marcin-chwedczuk/arducam/kicad/arducam/plot/arducam.pdf

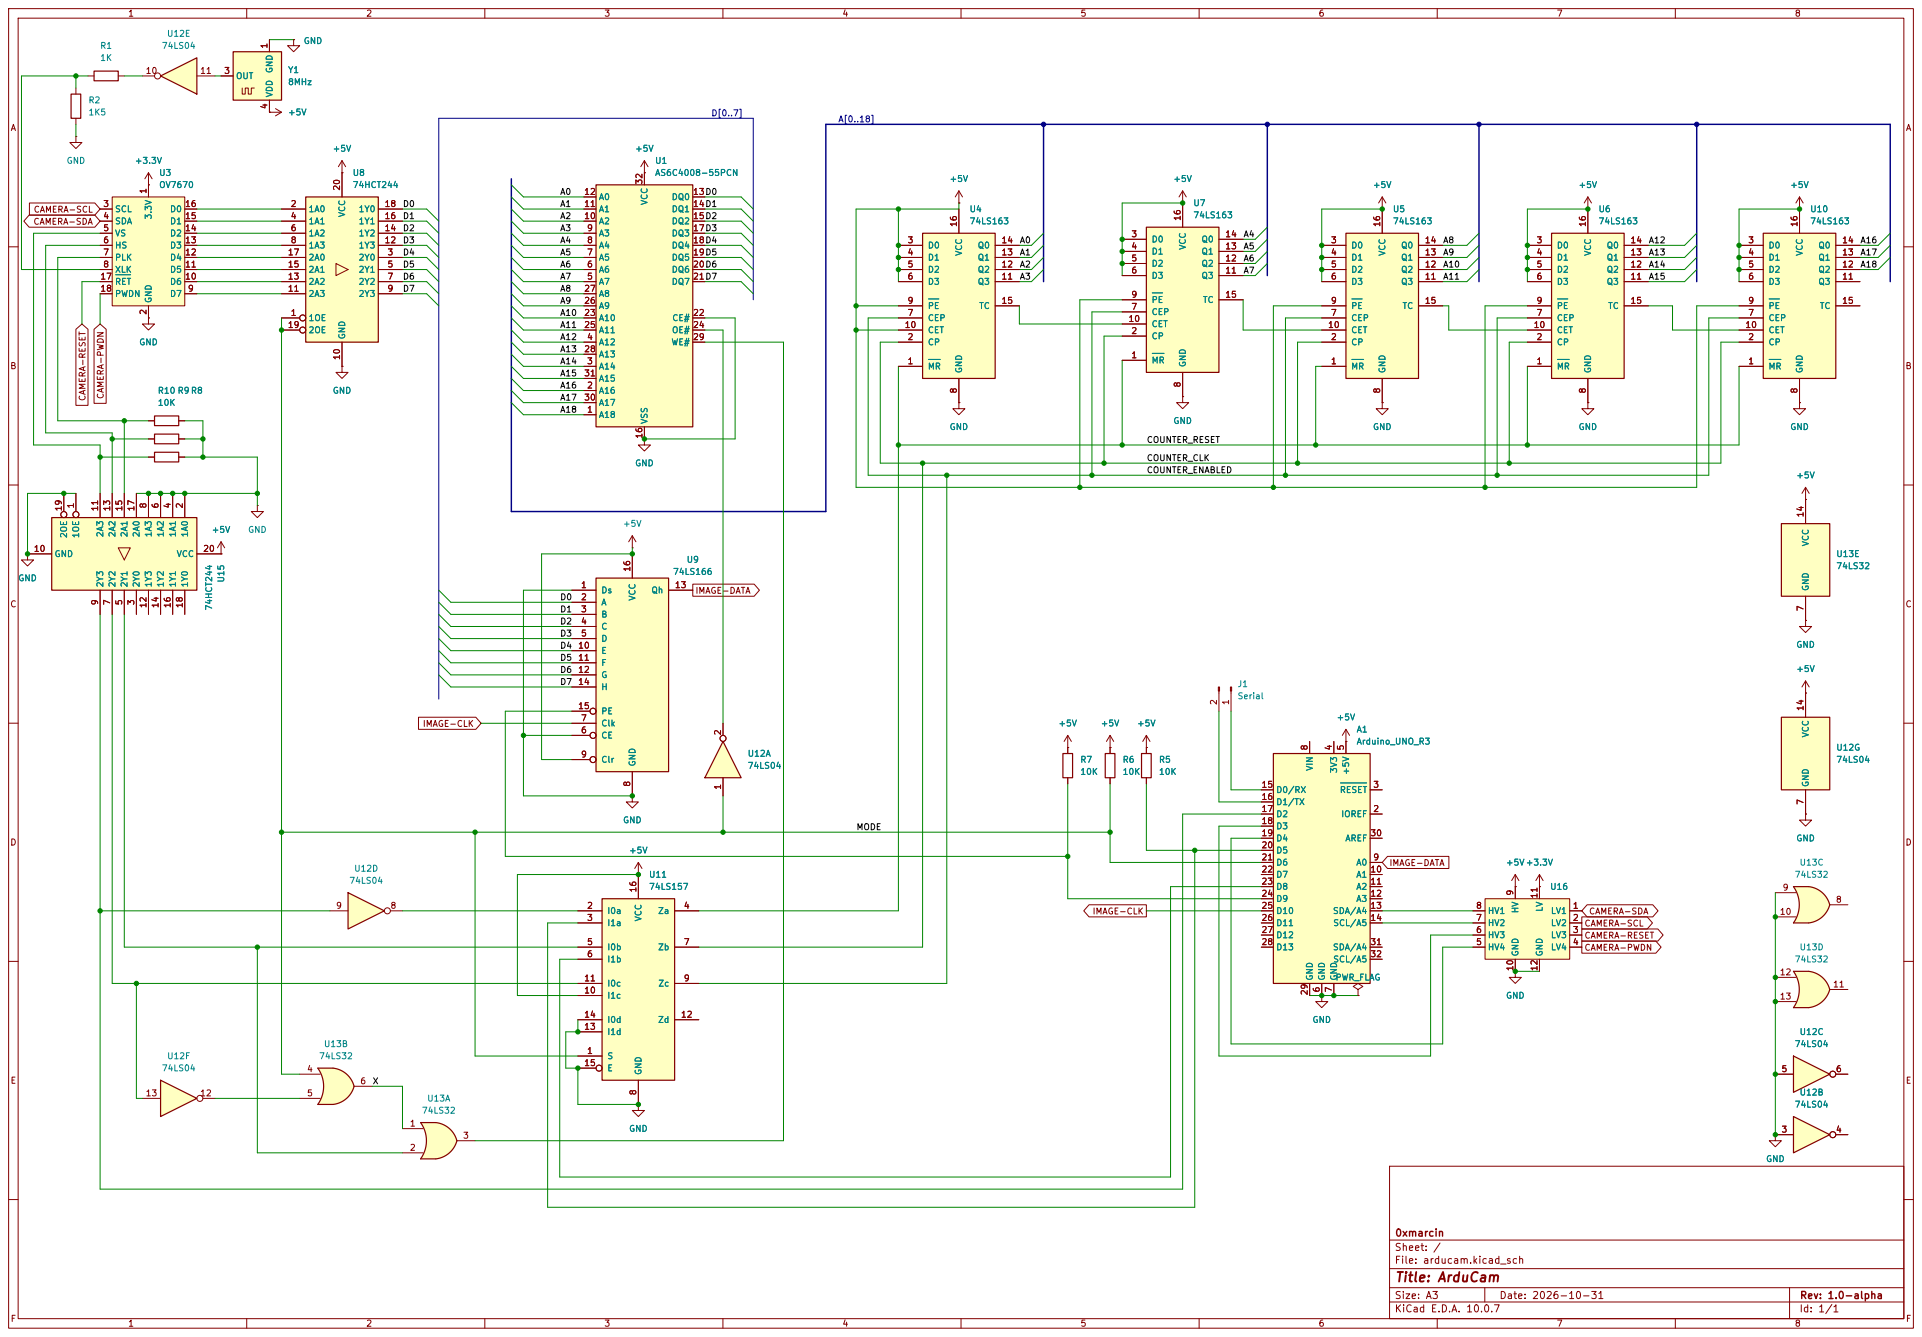
[picture p5: page 1]

CAMERA-SDA
CAMERA-SCL
74LS04 CAMERA-RESET CAMERA-PWDN
