marcin-chwedczuk/arducam/(commit log)

2026-10-31 Add JavaFX project skeleton based on pvc-scanner
    Copy the Maven multi-module setup (gui + domain), Maven wrapper, CI
    workflow and serial port code from pvc-scanner. Drop the 3D scanning
    parts and replace ScanProcess with ArduinoConnection, which opens the
    selected port and logs every line received from the Arduino.
    The toolbar has serial port selection, refresh, connect/disconnect and
    exit buttons. Parent artifactId renamed to arducam. Includes a simple
    Arduino test sketch that prints a line every second.
    [MainWindow.java]
2026-11-07 Add KiCad schematic early version
    [arducam.kicad_pcb, arducam.kicad_sch]
2026-11-07 Use JDK 25 in CI and update GitHub Actions
    The build targets Java 25 (required by JavaFX 27), so CI on JDK 17
    failed. Switch to Temurin 25, update checkout to v7 and setup-java
    to v6, and cache the Maven repository.
2026-11-07 second version of the schematic
    [arducam.kicad_sch]
2026-11-07 Fix schematic errors
    [arducam.kicad_pcb, arducam.kicad_sch]
2026-11-07 more fixes to schematic
    [arducam.kicad_sch]
2026-11-14 Add OV7670 snapshot camera test firmware
    Arduino Uno bring-up firmware for the OV7670 + AS6C4008 SRAM camera:
    memory/counter read test, SCCB ID and register read-back checks, VSYNC
    timing, colour-bar and real-image capture streamed as hex over serial,
    plus read-path diagnostics (d) and a counter-clear probe (p).
    OV7670 driver split into ov7670.h/.cpp; register tables from the Linux
    kernel driver, DCW scaling from LiveOV7670. Default output QVGA 320x240
    YUYV at PCLK 500 kHz (QQVGA selectable). Hardware findings: the internal
    clock is XCLK / (2 * (CLKRC + 1)), and COM13 UV swap is needed for YUYV.
    [arducam.ino, ov7670.cpp, ov7670.h]
2026-11-14 Add YUYV image renderer for arducam serial logs
    Converts the '# IMAGE w h YUYV n' block of a saved serial log to colour
    and grayscale PNGs (pure Python, no dependencies). Options: scale,
    --cw (rotate 90 degrees clockwise), --yvyu (swapped U/V, for captures
    taken before the COM13 fix).
    [render_yuyv.py]
2026-11-14 Split into self-test and arducam sketches, share OV7670 driver via symlinks
    The hardware test firmware moves to arduino/self-test. The OV7670 driver
    lives in arduino/common and is symlinked into each sketch, since Arduino
    only compiles files inside the sketch folder. arduino/arducam is a new,
    empty sketch for the firmware that talks to the Java application.
2026-11-14 Add arducam firmware implementing serial protocol v1
    - arduino/PROTOCOL.md: text commands, OK/ERR/INFO/TEST response lines,
    binary DATA blocks with CRC-16/XMODEM trailer.
    - arducam firmware 0.1.0: STATUS, POWER, RESET, MEMTEST, CAMTEST,
    PICTURE (QQVGA/QVGA YUYV, VGA raw Bayer) and READ. Does nothing on
    boot; camera stays powered down until the host asks.
    - OV7670 driver: capture mode selected at runtime via ov7670_configure()
    and OV7670_MODE_* macros; adds the kernel raw Bayer table.
    - self-test ported to the runtime mode API (still QVGA YUYV).
    [arducam.ino, ov7670.cpp, ov7670.h, self-test.ino]
2026-11-14 Implement arducam serial protocol v1 in the app
    Domain module:
    - ArducamClient: strict request/response protocol over streams,
    receives DATA blocks, CRC-16/XMODEM, per-command timeouts
    - ArducamDevice: handshake (STATUS), camera powered on only for
    camera commands, image re-fetched with READ on CRC mismatch
    - YUYV and BGGR Bayer decoding, 90 degree rotations
    - Unit tests with a scripted fake Arduino and real session lines
    GUI:
    - 250000 baud, no wait for reset (FTDI module, no auto-reset)
    - Toolbar: picture mode, take picture, memory/camera test,
    rotate CW/CCW, save as PNG/BMP
    - Picture view (rotated 90 CW by default), transfer progress bar
    - Log shows commands and responses but not bi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
2026-11-14 Keep camera powered while connected
    Powering the camera on and off around every picture gave blurry
    pictures: auto exposure and white balance had no time to settle.
    - Power on after the handshake, power off before closing the port
    (skipped when the connection is lost)
    - A failed power on keeps the connection; the next camera command
    tries again. A POWER_OFF error (firmware reset) powers on and
    retries once
    - Exit waits for power off, unless a command is still running
    [MainWindow.java]
2026-11-14 Settle time per mode, gamma and white balance for Bayer
    PICTURE resets auto exposure, so give it about 5 frames to settle:
    QQVGA 2000 ms, QVGA 4000 ms (VGA stays at 8000 ms). Timeouts are
    raised by the extra settle time.
    Raw Bayer data is linear and unbalanced (YUYV gets gamma and white
    balance inside the camera). After demosaicing apply gray-world white
    balance (gains limited to 0.5-4x) and display gamma 1/2.2.
2026-11-14 Support protocol v2 (CONFIG + PICTURE) and add Loop mode
    Protocol v2 separates CONFIG from PICTURE. The app sends CONFIG only
    when the mode changes or the configuration was lost (power on/off,
    CAMTEST, firmware reset), and settles only on the first picture after
    CONFIG (QQVGA 2000 ms, QVGA and VGA Bayer 4000 ms). NOT_CONFIGURED and
    POWER_OFF errors restore power/configuration and retry once.
    Loop mode takes pictures one after another until stopped; Stop takes
    effect after the current frame (no abort command). The log is trimmed
    when it grows past ~2 MB.
    Device tests now use a stateful fake of the v2 firmware.
    [MainWindow.java]
2026-11-14 Show "Stopping..." while loop mode finishes the current frame
    Stop takes effect only after the current frame, which can take several
    seconds. Until then the button reads "Stopping..." and is disabled.
2026-11-14 Display pictures without smoothing
    ImageView interpolates linearly when scaling up, even with
    smooth=false: a 160x120 colour bar picture shown at ~4x had 4 px wide
    gradients between the bars. Replace it with PixelatedImageView, which
    draws on a Canvas with image smoothing disabled (nearest neighbour,
    aspect ratio kept, centered).
    The rest of the pipeline (decoding, rotation, WritableImage, PNG/BMP
    saving) is 1:1 and was not blurring. Add an integration test that
    checks a scaled checkerboard contains only pure black/white pixels.
    [MainWindow.java]
2026-11-14 Support protocol v3 camera options in the library
    - CameraConfig: everything CONFIG accepts (fmt incl. y8, res, pattern,
    auto, effect, brightness, contrast, saturation, exposure, gain).
    Validates the protocol rules (supported combinations, ranges, no DSP
    adjustments with Bayer, exposure/gain only with auto=off) and sends
    only the adjustments that are set. Keeps the command within the
    127 character limit.
    - No settling for the first picture when auto exposure is off.
    - Y8 (grayscale, 1 byte/pixel) format and decoding.
    - Handshake accepts protocol 2 and 3; v3-only options are refused on a
    v2 device before anything is sent.
    - PictureMode presets are now CameraConfigs; the GUI is unc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
2026-11-14 Firmware 0.3.0: protocol v3 with CONFIG, Y8, effects and adjustments
    - 0.1.1: VGA Bayer uses CLKRC 0x03 (PCLK 500 kHz, 800 ms frames); the
    timing model counts 2 internal clocks per pixel in every mode, as
    measured.
    - 0.2.0 (protocol v2): CONFIG writes the camera registers once; PICTURE
    only captures, so auto exposure stays converged between pictures and
    capture waits at most 2 frames. STATUS reports config=, new error
    NOT_CONFIGURED.
    - 0.3.0 (protocol v3, compatible with v2): CONFIG fmt=y8 sends only the
    Y bytes (half the transfer), plus effect=, brightness=, contrast=,
    saturation=, exposure= and gain=. Command lines up to 159 characters.
    - OV7670 driver: effect and image adjus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
    [arducam.ino, ov7670.cpp, ov7670.h]
